pesalaG/Function-Generator/images/WhatsApp Image 2023-08-26 at 15.14.37.jpg

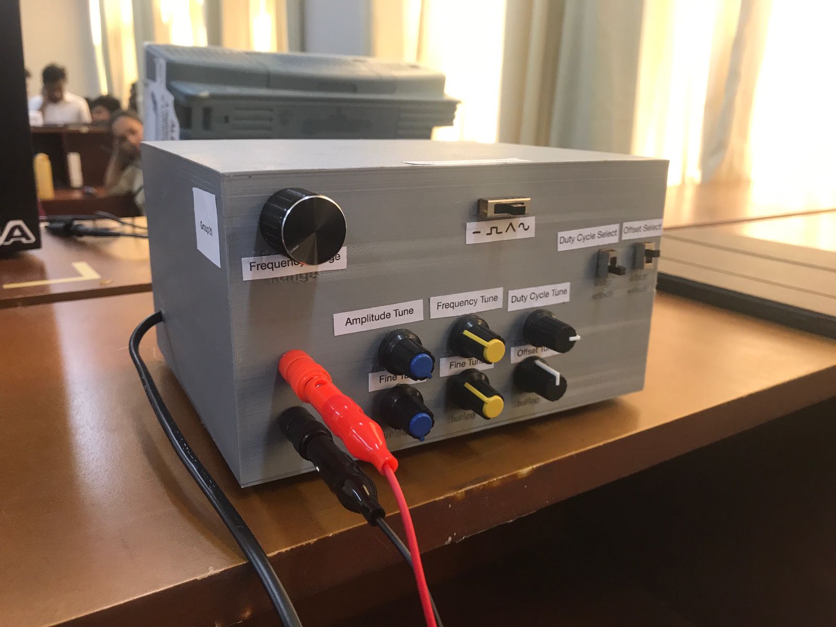
images/WhatsApp Image 2023-08-26 at 15.14.37.jpg
