pesalaG/Function-Generator/enclosure_design/func_gen1.PNG

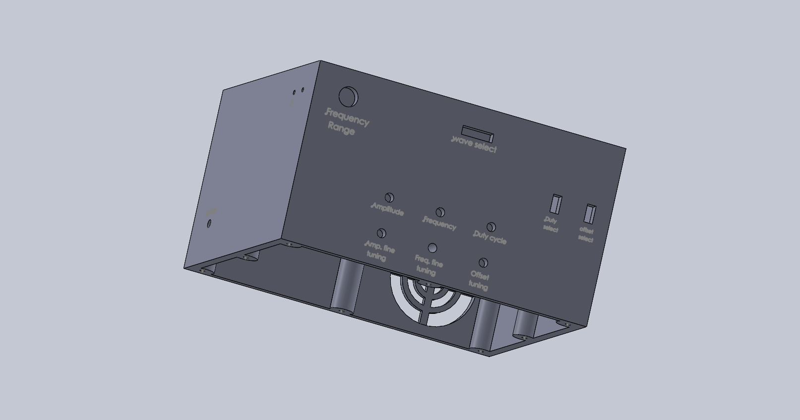
enclosure_design/func_gen1.PNG
