pesalaG/Function-Generator/enclosure_design/func_gen12.PNG

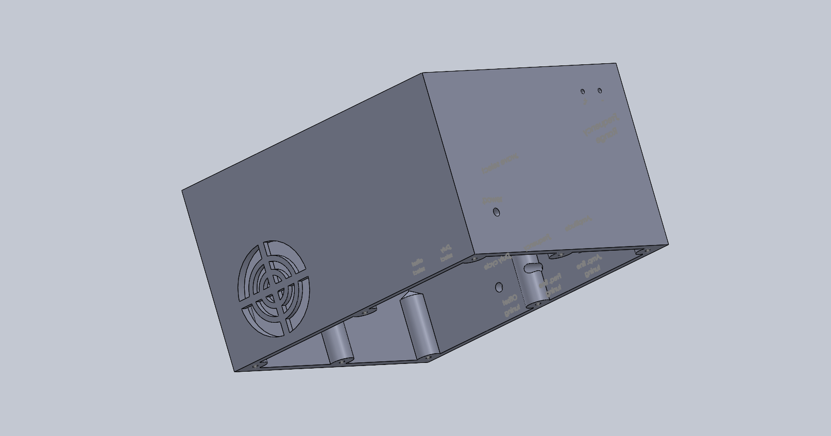
enclosure_design/func_gen12.PNG
