pesalaG/Function-Generator/enclosure_design/func_gen.PNG

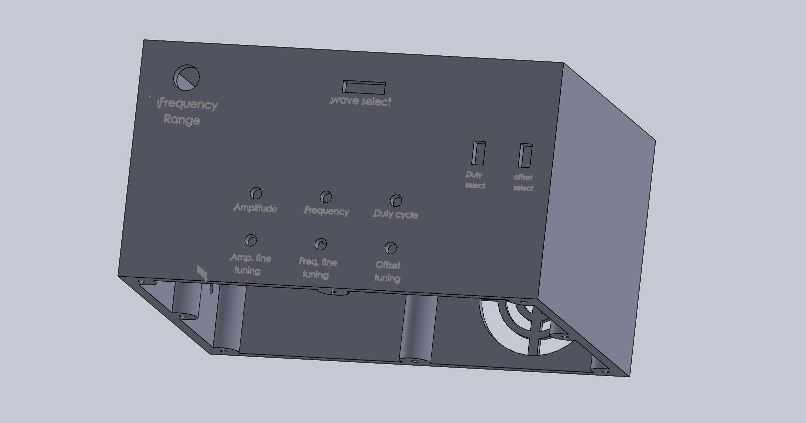
enclosure_design/func_gen.PNG
