pesalaG/Function-Generator/enclosure_design/func_generator1.PNG

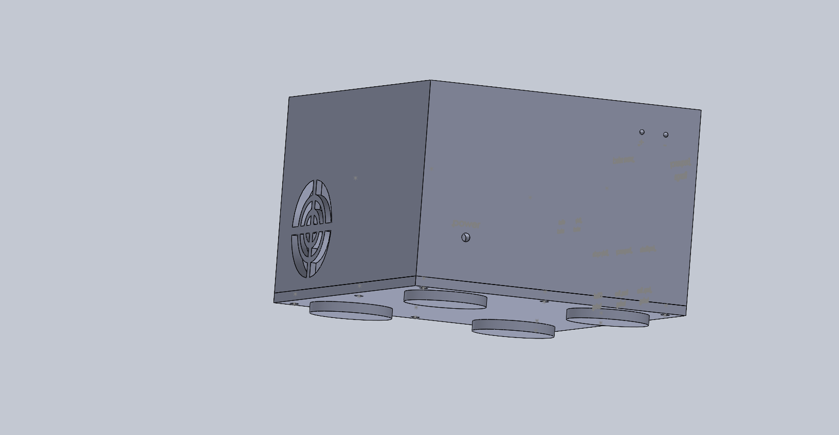
enclosure_design/func_generator1.PNG
