pesalaG/Function-Generator/enclosure_design/func_generator.PNG

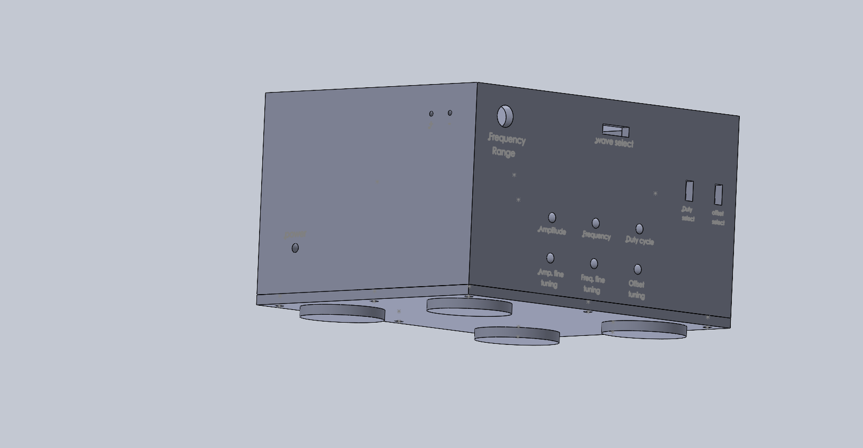
enclosure_design/func_generator.PNG
