pesalaG/Function-Generator/enclosure_design/func_generator.SLDASM

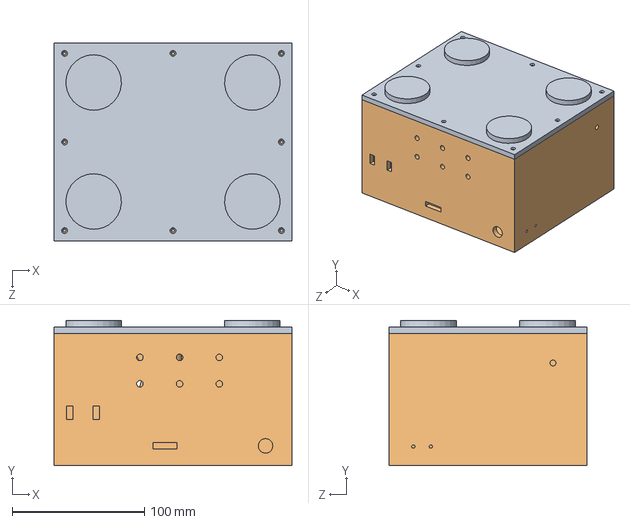
[picture p20: CAD file, 2023-08-27]
enclosure_design/func_generator.SLDASM
180.0 x 110.0 x 150.0 mm
bottom
func_gen
