pesalaG/Function-Generator/enclosure_design/func_gen.SLDPRT

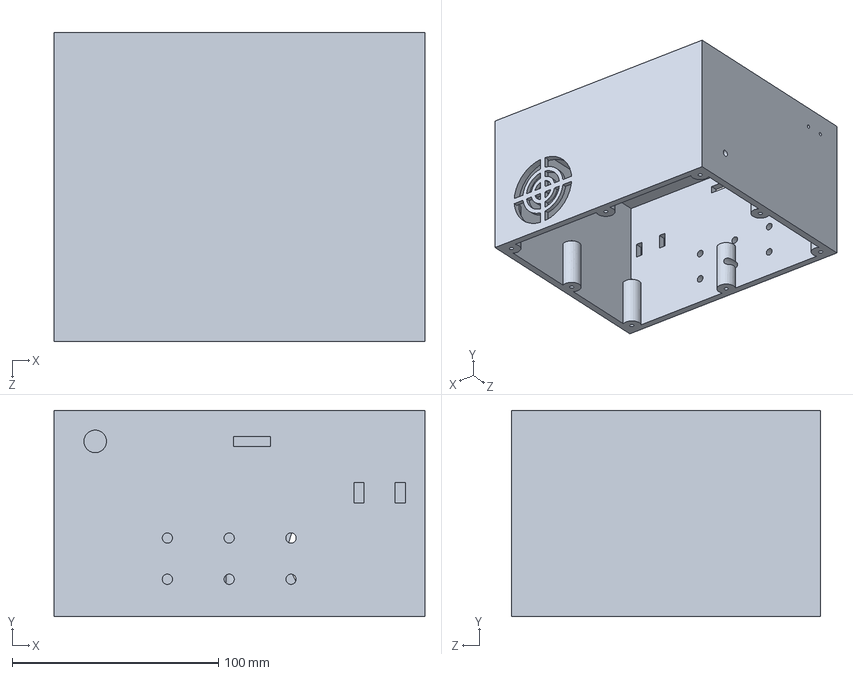
[picture p21: CAD file, 2023-08-27]
enclosure_design/func_gen.SLDPRT
180.0 x 100.0 x 150.0 mm
