pesalaG/Function-Generator/enclosure_design/bottom.SLDPRT

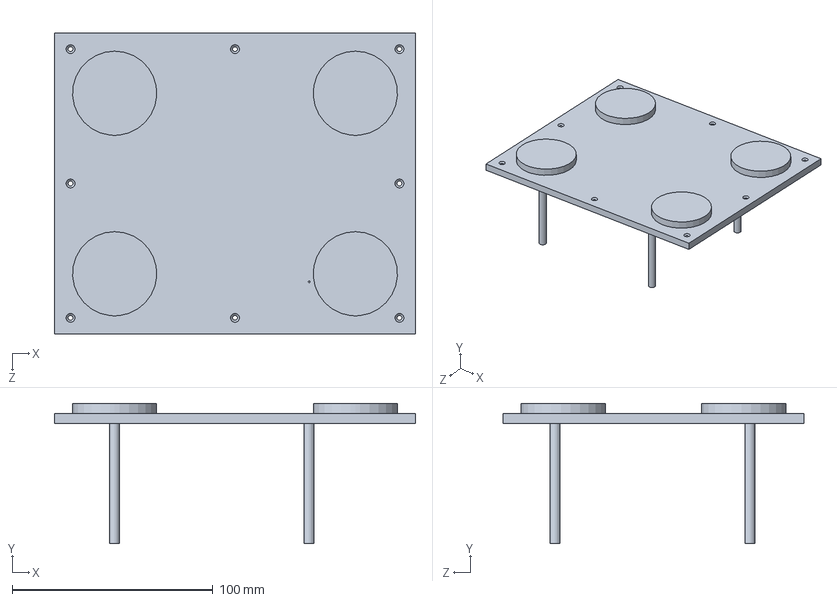
[picture p22: CAD file, 2023-08-27]
enclosure_design/bottom.SLDPRT
180.0 x 70.0 x 150.0 mm
