pesalaG/Function-Generator/(list of files, cad)

Other CAD files:
enclosure_design/bottom.STL
enclosure_design/func_gen.STL
