pesalaG/Function-Generator/(list of files, drawings)

Other design files:
PCB/PCB1.PcbDoc
PCB/Sheet1.SchDoc
simulation/Function_generator.ms14
